Safecast/Safecast-Air/hardware/isb_adaptor/isb_adaptor.kicad_pcb

## KiCad design hardware/isb_adaptor/isb_adaptor.kicad_pcb (2015-06-11)

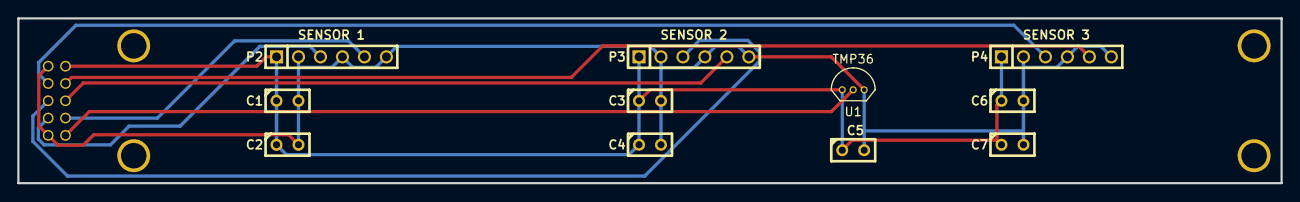
[picture p2: board isb_adaptor.kicad_pcb from above]

Board: 2 copper layers, 146.1 x 19.1 mm, 16 parts (1 on the bottom side), 9 nets.

Parts:
C1, C3, C5: 10nF; C1
C2, C4, C6: 100nF; C1
C7: 0.1uF; C1
M1, M2, M3, M4: VAL**; 4-40
P1: CONN_5X2; 5X2_2MM_SHRD_HEADER
P2, P3, P4: CONN_6; PIN_ARRAY-6X1
U1: TMP36

Connections:
/AUX1: P1.7, P2.5
/AUX2: P1.5, P3.5
/AUX3: P1.3, P4.5
/TMP: P1.9, U1.2
/VIN: C1.1, C2.1, C3.1, C4.1, C5.1, C6.1, C7.1, P1.1, P2.1, P3.1, P4.1, U1.1
/WRK1: P1.8, P2.3
/WRK2: P1.6, P3.3
/WRK3: P1.4, P4.3
GND: C1.2, C2.2, C3.2, C4.2, C5.2, C6.2, C7.2, P1.2, P1.10, P2.2, P2.4, P2.6, P3.2, P3.4, P3.6, P4.2, P4.4, P4.6, U1.3
